Sopehurt/kiosk_pcb/PCB_CAT_Vending_Machine_V1.0.kicad_pcb

## KiCad design PCB_CAT_Vending_Machine_V1.0.kicad_pcb (2026-05-17)

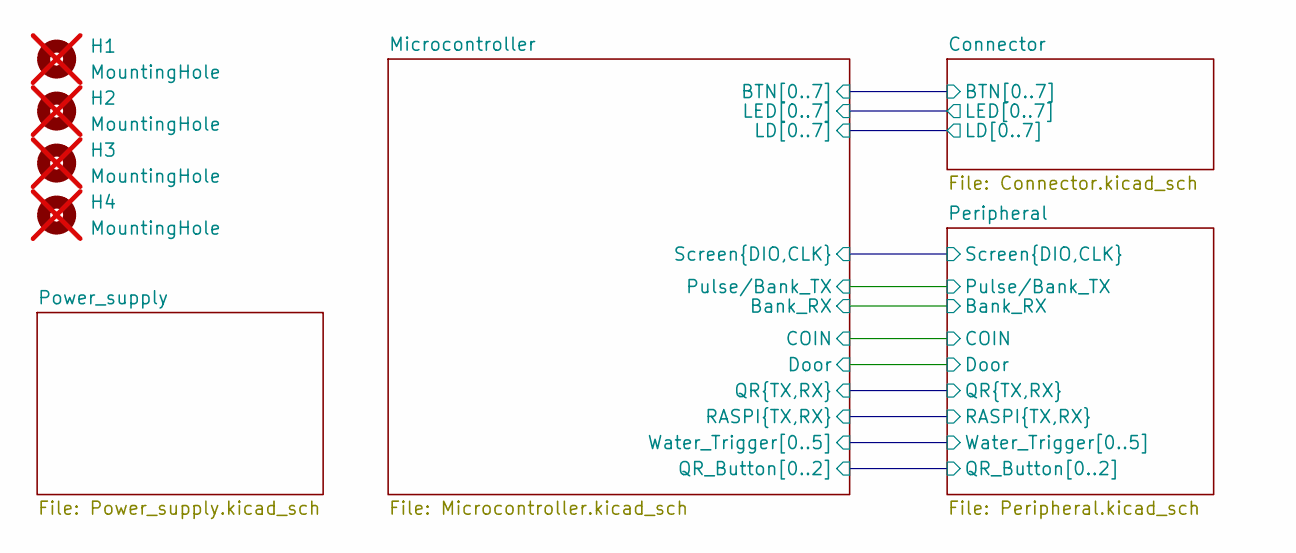
[picture p1: schematic PCB_CAT_Vending_Machine_V1.0.kicad_sch]

Parts:
H1, H2, H3, H4: MountingHole; MountingHole_3.2mm_M3_Pad_TopBottom; not fitted

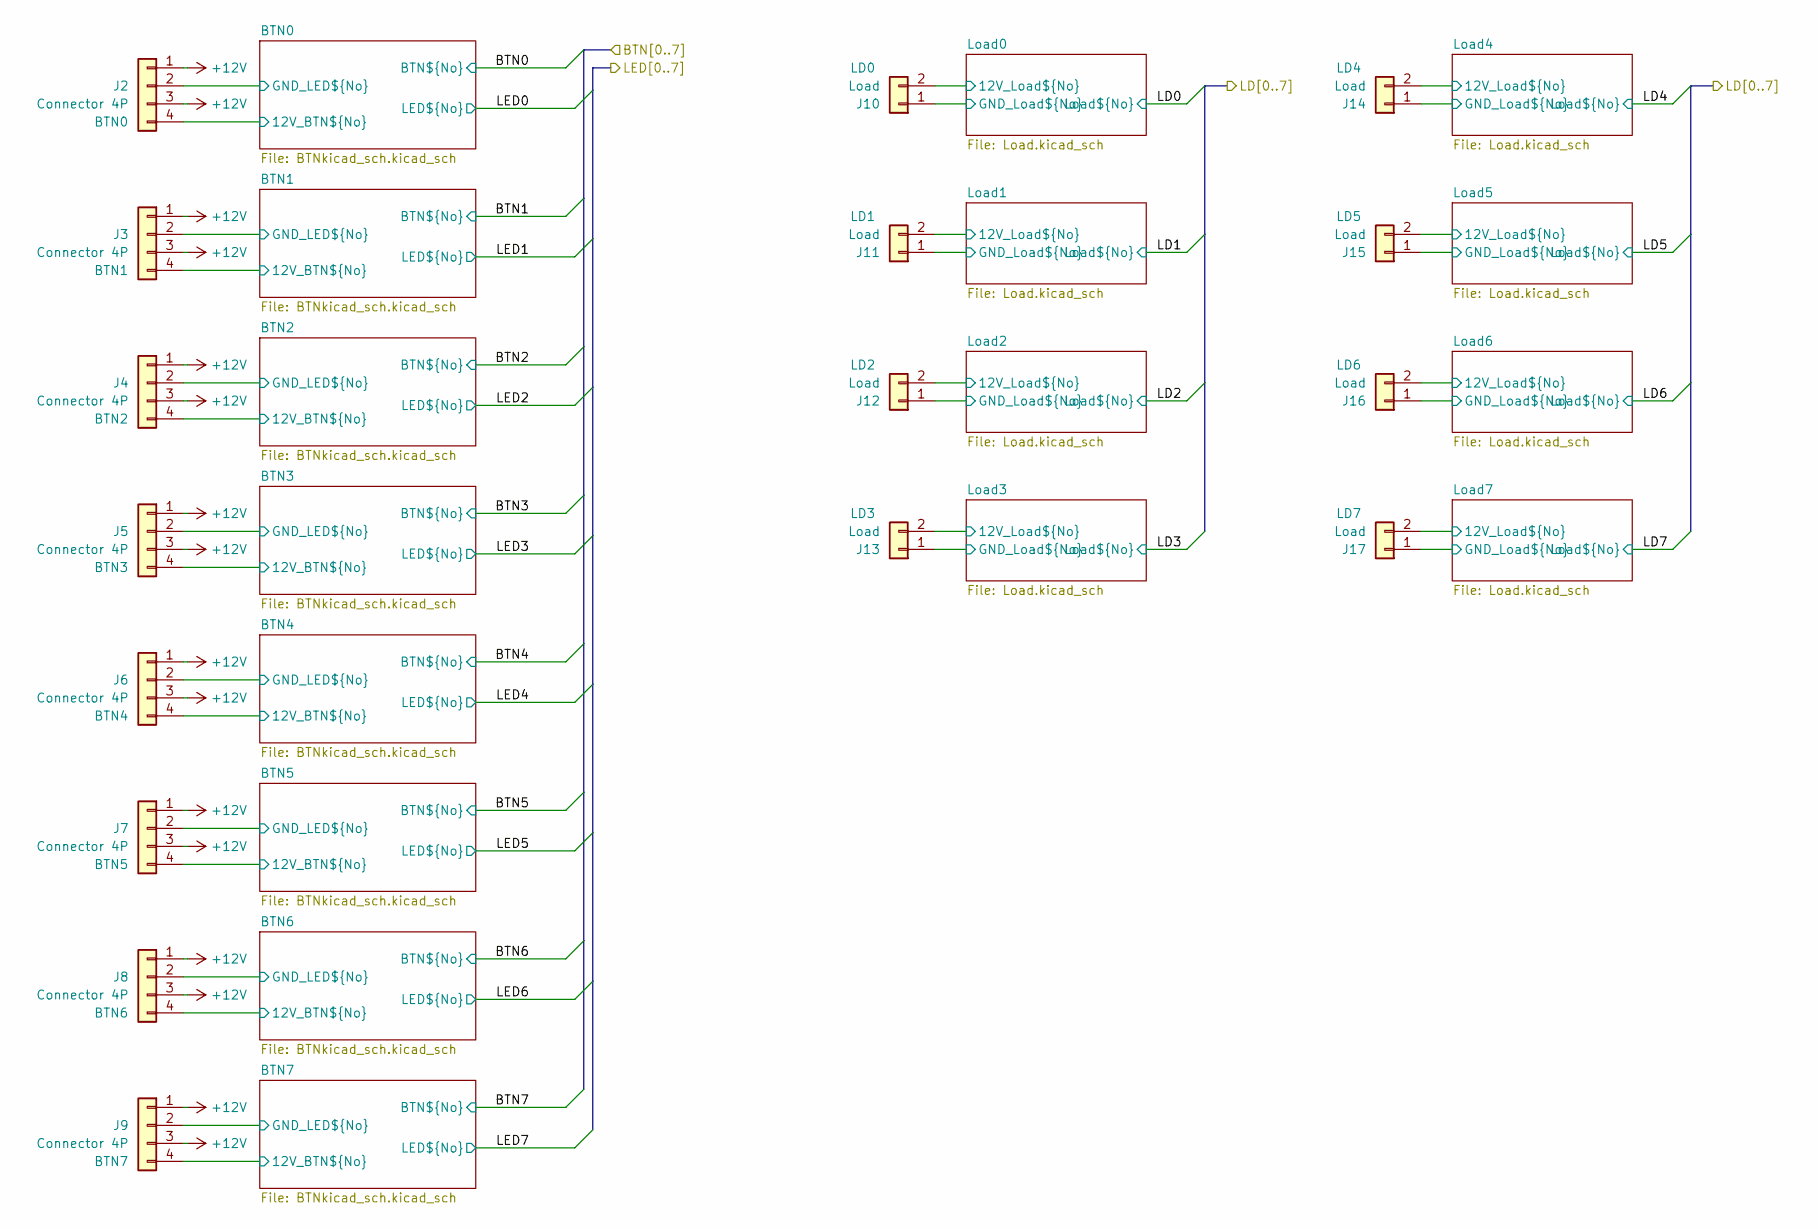
[picture p2: schematic Connector.kicad_sch]

Parts:
J2, J3, J4, J5, J6, J7, J8, J9: Connector 4P; JST_XH_B4B-XH-A_1x04_P2.50mm_Vertical; LCSC C7429634
J10, J11, J12, J13, J14, J15, J16, J17: Load; CONN-TH_CH5.08-2A; LCSC C27692

Connections:
+12V: J2.1, J2.3, J3.1, J3.3, J4.1, J4.3, J5.1, J5.3, J6.1, J6.3, J7.1, J7.3, J8.1, J8.3, J9.1, J9.3, J10.2, J11.2, J12.2, J13.2, J14.2, J15.2, J16.2, J17.2; also elsewhere on the board
/Connector/BTN0/12V_BTN0: J2.4; also elsewhere on the board
/Connector/BTN0/GND_LED0: J2.2; also elsewhere on the board
/Connector/BTN1/12V_BTN1: J3.4; also elsewhere on the board
/Connector/BTN1/GND_LED1: J3.2; also elsewhere on the board
/Connector/BTN2/12V_BTN2: J4.4; also elsewhere on the board
/Connector/BTN2/GND_LED2: J4.2; also elsewhere on the board
/Connector/BTN3/12V_BTN3: J5.4; also elsewhere on the board
/Connector/BTN3/GND_LED3: J5.2; also elsewhere on the board
/Connector/BTN4/12V_BTN4: J6.4; also elsewhere on the board
/Connector/BTN4/GND_LED4: J6.2; also elsewhere on the board
/Connector/BTN5/12V_BTN5: J7.4; also elsewhere on the board
/Connector/BTN5/GND_LED5: J7.2; also elsewhere on the board
/Connector/BTN6/12V_BTN6: J8.4; also elsewhere on the board
/Connector/BTN6/GND_LED6: J8.2; also elsewhere on the board
/Connector/BTN7/12V_BTN7: J9.4; also elsewhere on the board
/Connector/BTN7/GND_LED7: J9.2; also elsewhere on the board
/Connector/Load0/GND_Load0: J10.1; also elsewhere on the board
/Connector/Load1/GND_Load1: J11.1; also elsewhere on the board
/Connector/Load2/GND_Load2: J12.1; also elsewhere on the board
/Connector/Load3/GND_Load3: J13.1; also elsewhere on the board
/Connector/Load4/GND_Load4: J14.1; also elsewhere on the board
/Connector/Load5/GND_Load5: J15.1; also elsewhere on the board
/Connector/Load6/GND_Load6: J16.1; also elsewhere on the board
/Connector/Load7/GND_Load7: J17.1; also elsewhere on the board

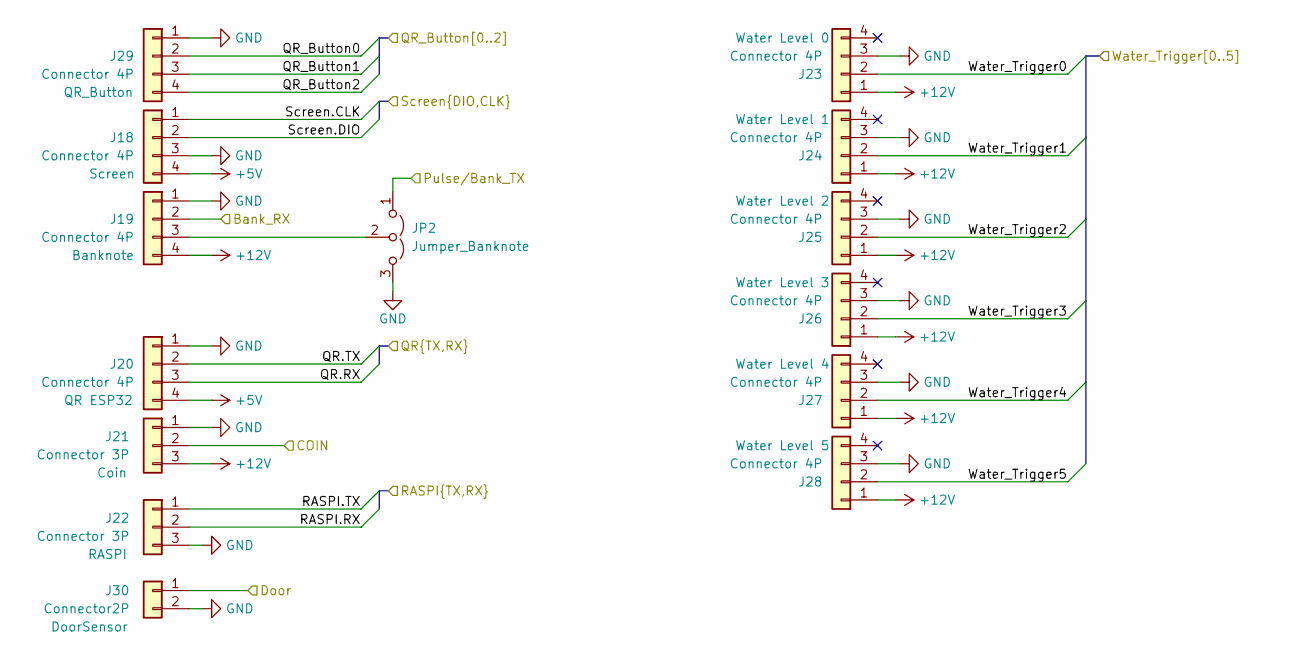
[picture p3: schematic Peripheral.kicad_sch]

Parts:
J18, J19, J20, J23, J24, J25, J26, J27, J28, J29: Connector 4P; JST_XH_B4B-XH-A_1x04_P2.50mm_Vertical; LCSC C7429634
J21, J22: Connector 3P; JST_XH_B3B-XH-A_1x03_P2.50mm_Vertical; LCSC C7429633
J30: Connector2P; JST_XH_B2B-XH-A_1x02_P2.50mm_Vertical; LCSC C42441529
JP2: Jumper_Banknote; PinHeader_1x03_P2.54mm_Vertical; LCSC C52016391

Connections:
+5V: J18.4, J20.4; also elsewhere on the board
+12V: J19.4, J21.3, J23.1, J24.1, J25.1, J26.1, J27.1, J28.1; also elsewhere on the board
/Microcontroller/Bank_RX: J19.2; also elsewhere on the board
/Microcontroller/COIN: J21.2; also elsewhere on the board
/Microcontroller/Door: J30.1; also elsewhere on the board
/Microcontroller/Pulse/Bank_TX: JP2.1 (A); also elsewhere on the board
/Microcontroller/QR.RX: J20.3; also elsewhere on the board
/Microcontroller/QR.TX: J20.2; also elsewhere on the board
/Microcontroller/QR_Button0: J29.2; also elsewhere on the board
/Microcontroller/QR_Button1: J29.3; also elsewhere on the board
/Microcontroller/QR_Button2: J29.4; also elsewhere on the board
/Microcontroller/RASPI.RX: J22.2; also elsewhere on the board
/Microcontroller/RASPI.TX: J22.1; also elsewhere on the board
/Microcontroller/Screen.CLK: J18.1; also elsewhere on the board
/Microcontroller/Screen.DIO: J18.2; also elsewhere on the board
/Microcontroller/Water_Trigger0: J23.2; also elsewhere on the board
/Microcontroller/Water_Trigger1: J24.2; also elsewhere on the board
/Microcontroller/Water_Trigger2: J25.2; also elsewhere on the board
/Microcontroller/Water_Trigger3: J26.2; also elsewhere on the board
/Microcontroller/Water_Trigger4: J27.2; also elsewhere on the board
/Microcontroller/Water_Trigger5: J28.2; also elsewhere on the board
GND: J18.3, J19.1, J20.1, J21.1, J22.3, J23.3, J24.3, J25.3, J26.3, J27.3, J28.3, J29.1, J30.2, JP2.3 (B); also elsewhere on the board
unnamed: J19.3, JP2.2 (C)

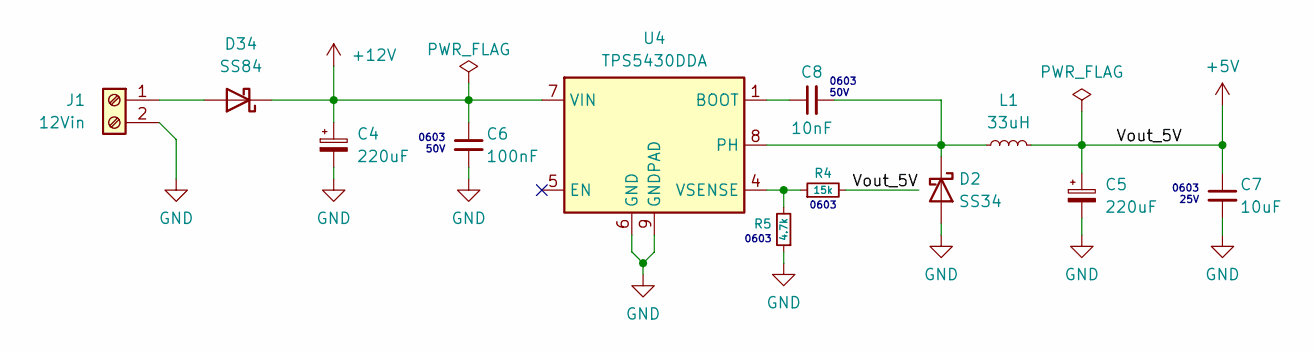
[picture p4: schematic Power_supply.kicad_sch]

Parts:
C4, C5: 220uF; CP_Elec_6.3x7.7; LCSC C696188
C6: 100nF; C_0603_1608Metric; LCSC C14663
C7: 10uF; C_0603_1608Metric; LCSC C96446
C8: 10nF; C_0603_1608Metric; LCSC C57112
D2: SS34; D_SMA; LCSC C8678
D34: SS84; D_SMC; JLC C2943761
J1: 12Vin; CONN-TH_2P-P5.00_XY2500V-D-5.00-2P; LCSC C505779
L1: 33uH; L_TechFuse_SL0650; LCSC C5127476
R4: 15k; R_0603_1608Metric; LCSC C22809
R5: 4.7k; R_0603_1608Metric; LCSC C23162
U4: TPS5430DDA; TI_SO-PowerPAD-8_ThermalVias; LCSC C9864

Connections:
+5V: C5.1, C7.1, L1.2, R4.2; also elsewhere on the board
+12V: C4.1, C6.1, D34.1 (K), U4.7 (VIN); also elsewhere on the board
GND: C4.2, C5.2, C6.2, C7.2, D2.2 (A), J1.2, R5.1, U4.6 (GND), U4.9 (GNDPAD); also elsewhere on the board
unnamed: C8.2, D2.1 (K), L1.1, U4.8 (PH)
unnamed: D34.2 (A), J1.1
unnamed: C8.1, U4.1 (BOOT)
unnamed: R4.1, R5.2, U4.4 (VSENSE)

Notes on the sheet:
0603 50V
0603 25V
0603

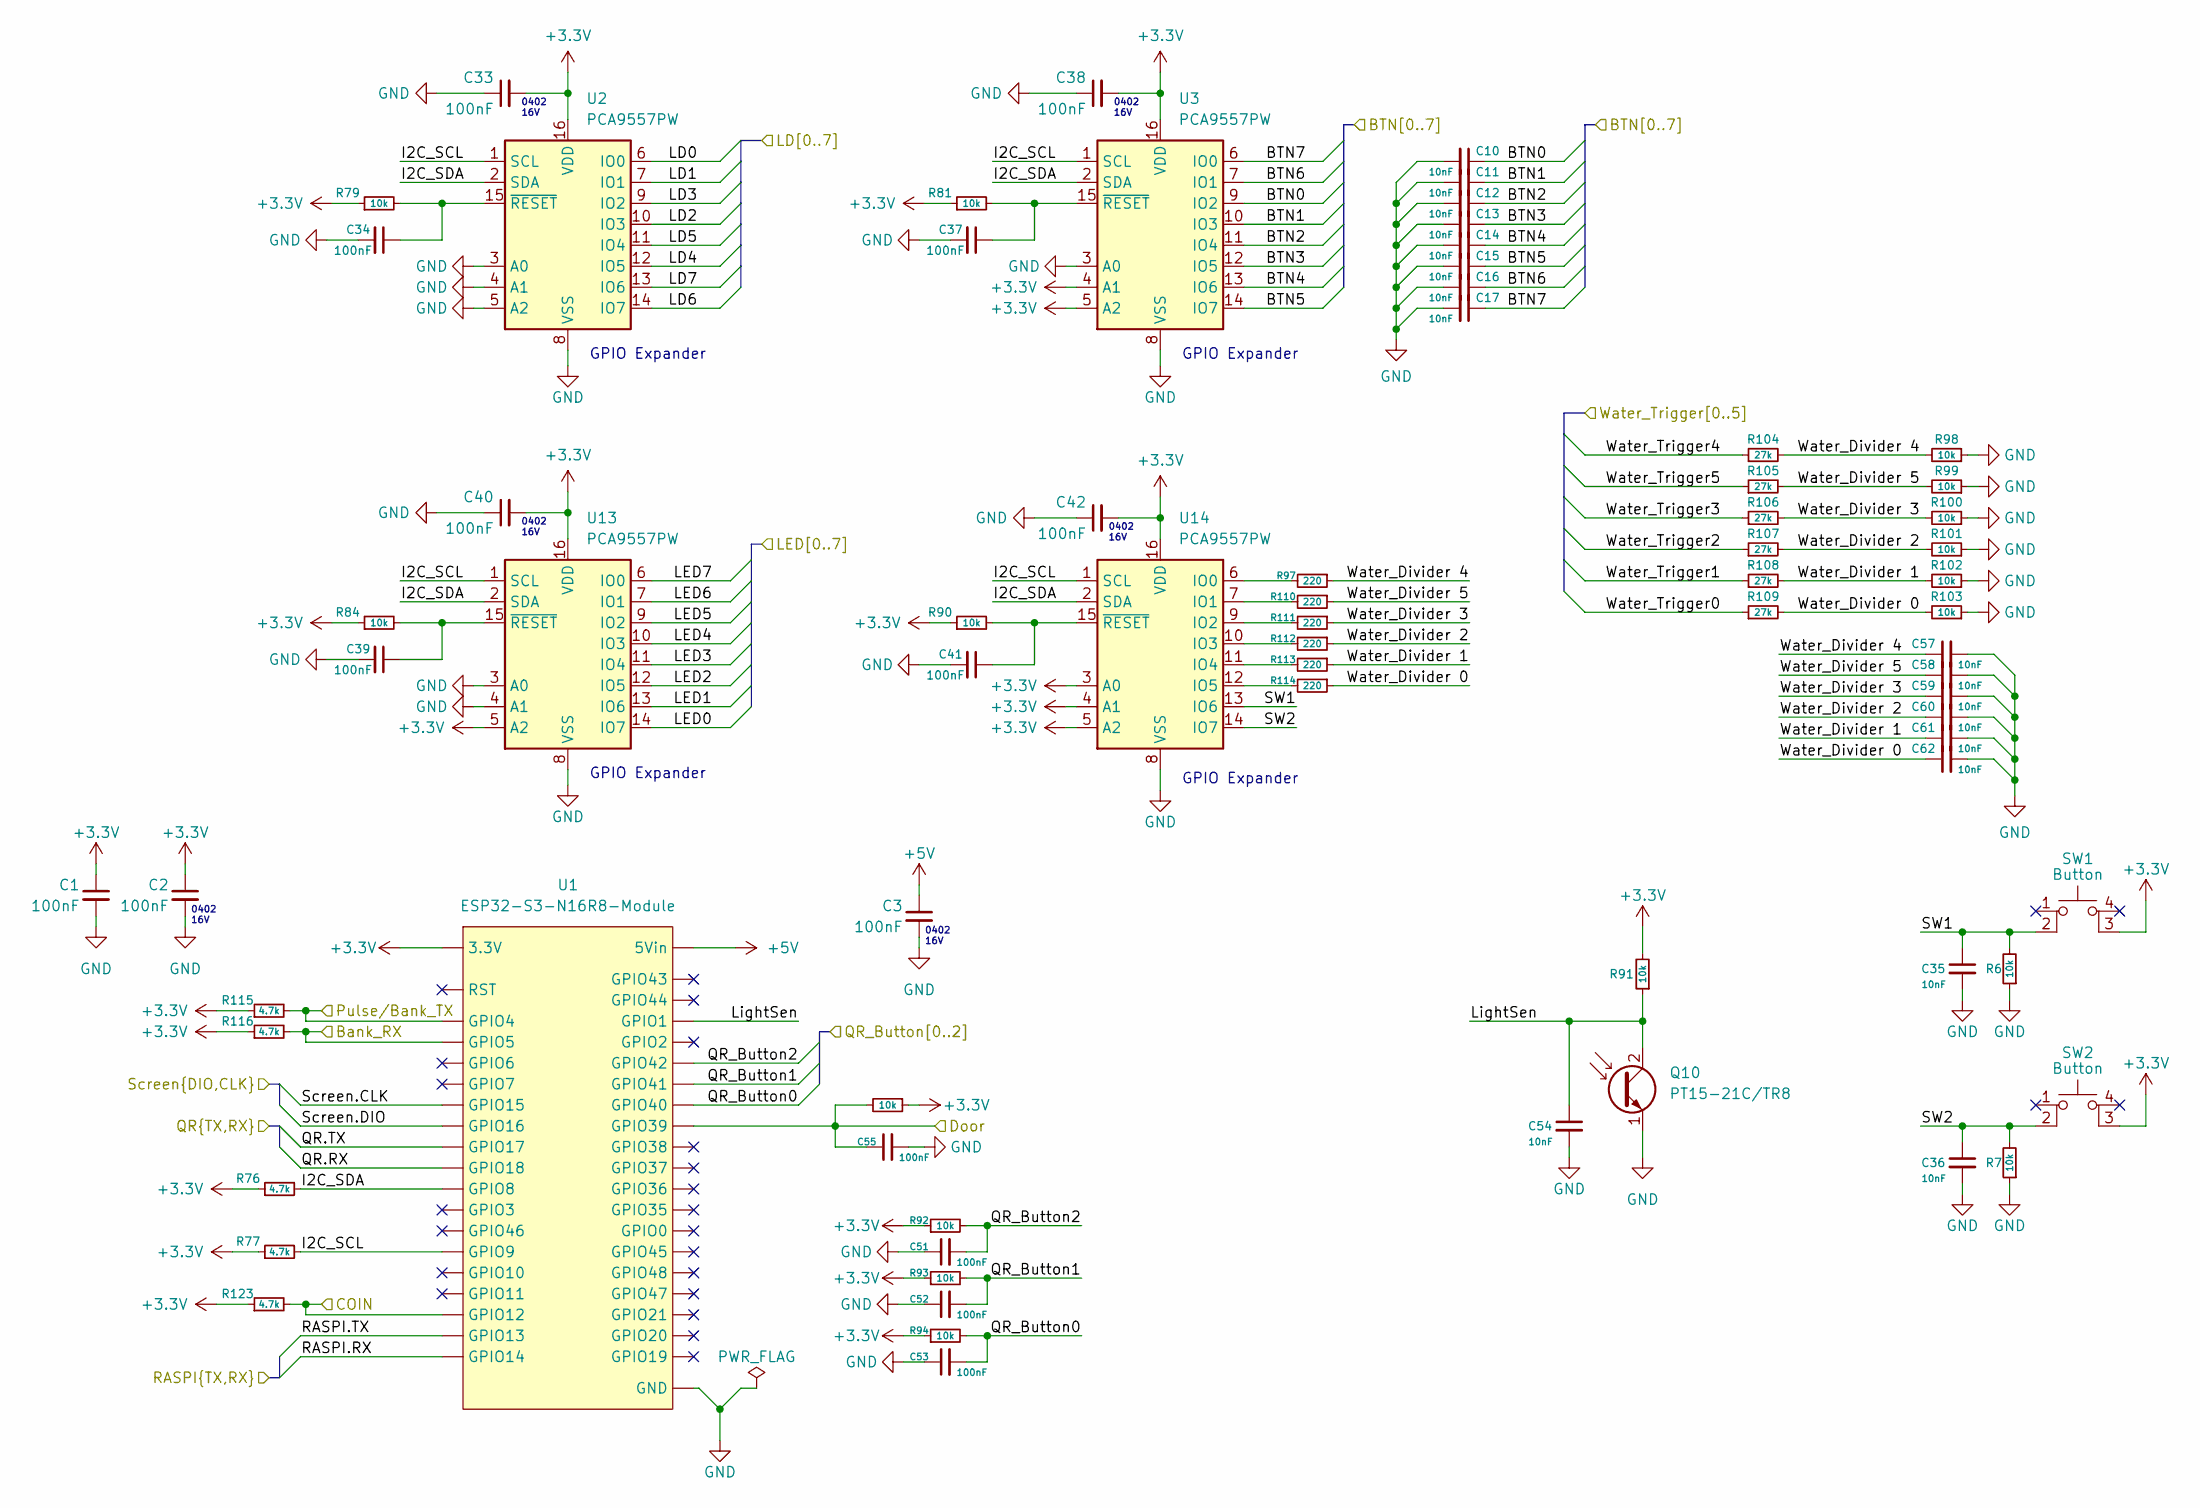
[picture p5: schematic Microcontroller.kicad_sch]

Parts:
C1, C2, C3, C33, C34, C37, C38, C39, C40, C41, C42, C51, C52, C53, C55: 100nF; C_0402_1005Metric; LCSC C1525
C10, C11, C12, C13, C14, C15, C16, C17, C35, C36, C54, C57, C58, C59, C60, C61, C62: 10nF; C_0402_1005Metric; LCSC C15195
Q10: PT15-21C/TR8; LED_1206_3216Metric; LCSC C41383389
R6, R7, R79, R81, R84, R90, R91, R92, R93, R94, R95, R98, R99, R100, R101, R102, R103: 10k; R_0402_1005Metric; LCSC C25744
R76, R77, R115, R116, R123: 4.7k; R_0402_1005Metric; LCSC C25900
R97, R110, R111, R112, R113, R114: 220; R_0402_1005Metric; LCSC C25091
R104, R105, R106, R107, R108, R109: 27k; R_0603_1608Metric; LCSC C22967
SW1, SW2: Button; 430182043816; LCSC C5340127
U1: ESP32-S3-N16R8-Module; ESP32-S3 N16R8-Module
U2, U3, U13, U14: PCA9557PW; TSSOP-16_4.4x5mm_P0.65mm; LCSC C141380

Connections:
+3.3V: C1.1, C2.1, C33.2, C38.2, C40.2, C42.2, R76.1, R77.1, R79.1, R81.1, R84.1, R90.1, R91.2, R92.1, R93.1, R94.1, R95.1, R115.1, R116.1, R123.1, SW1.3 (K), SW2.3 (K), U1.1 (3.3V), U1.2 (3.3V), U2.16 (VDD), U3.4 (A1), U3.5 (A2), U3.16 (VDD), U13.5 (A2), U13.16 (VDD), U14.3 (A0), U14.4 (A1), U14.5 (A2), U14.16 (VDD); also elsewhere on the board
+5V: C3.1, U1.21 (5Vin); also elsewhere on the board
/Connector/BTN0: C10.1, U3.9 (IO2); also elsewhere on the board
/Connector/BTN1: C11.1, U3.10 (IO3); also elsewhere on the board
/Connector/BTN2: C12.1, U3.11 (IO4); also elsewhere on the board
/Connector/BTN3: C13.1, U3.12 (IO5); also elsewhere on the board
/Connector/BTN4: C14.1, U3.13 (IO6); also elsewhere on the board
/Connector/BTN5: C15.1, U3.14 (IO7); also elsewhere on the board
/Connector/BTN6: C16.1, U3.7 (IO1); also elsewhere on the board
/Connector/BTN7: C17.1, U3.6 (IO0); also elsewhere on the board
/Connector/LD0: U2.6 (IO0); also elsewhere on the board
/Connector/LD1: U2.7 (IO1); also elsewhere on the board
/Connector/LD2: U2.10 (IO3); also elsewhere on the board
/Connector/LD3: U2.9 (IO2); also elsewhere on the board
/Connector/LD4: U2.12 (IO5); also elsewhere on the board
/Connector/LD5: U2.11 (IO4); also elsewhere on the board
/Connector/LD6: U2.14 (IO7); also elsewhere on the board
/Connector/LD7: U2.13 (IO6); also elsewhere on the board
/Connector/LED0: U13.14 (IO7); also elsewhere on the board
/Connector/LED1: U13.13 (IO6); also elsewhere on the board
/Connector/LED2: U13.12 (IO5); also elsewhere on the board
/Connector/LED3: U13.11 (IO4); also elsewhere on the board
/Connector/LED4: U13.10 (IO3); also elsewhere on the board
/Connector/LED5: U13.9 (IO2); also elsewhere on the board
/Connector/LED6: U13.7 (IO1); also elsewhere on the board
/Connector/LED7: U13.6 (IO0); also elsewhere on the board
/Microcontroller/Bank_RX: R116.2, U1.5 (GPIO5); also elsewhere on the board
/Microcontroller/COIN: R123.2, U1.18 (GPIO12); also elsewhere on the board
/Microcontroller/Door: C55.1, R95.2, U1.36 (GPIO39); also elsewhere on the board
/Microcontroller/I2C_SCL: R77.2, U1.15 (GPIO9), U2.1 (SCL), U3.1 (SCL), U13.1 (SCL), U14.1 (SCL)
/Microcontroller/I2C_SDA: R76.2, U1.12 (GPIO8), U2.2 (SDA), U3.2 (SDA), U13.2 (SDA), U14.2 (SDA)
/Microcontroller/LightSen: C54.1, Q10.2 (C), R91.1, U1.41 (GPIO1)
/Microcontroller/Pulse/Bank_TX: R115.2, U1.4 (GPIO4); also elsewhere on the board
/Microcontroller/QR.RX: U1.11 (GPIO18); also elsewhere on the board
/Microcontroller/QR.TX: U1.10 (GPIO17); also elsewhere on the board
/Microcontroller/QR_Button0: C53.2, R94.2, U1.37 (GPIO40); also elsewhere on the board
/Microcontroller/QR_Button1: C52.2, R93.2, U1.38 (GPIO41); also elsewhere on the board
/Microcontroller/QR_Button2: C51.2, R92.2, U1.39 (GPIO42); also elsewhere on the board
/Microcontroller/RASPI.RX: U1.20 (GPIO14); also elsewhere on the board
/Microcontroller/RASPI.TX: U1.19 (GPIO13); also elsewhere on the board
/Microcontroller/SW1: C35.1, R6.2, SW1.2, U14.13 (IO6)
/Microcontroller/SW2: C36.1, R7.2, SW2.2, U14.14 (IO7)
/Microcontroller/Screen.CLK: U1.8 (GPIO15); also elsewhere on the board
/Microcontroller/Screen.DIO: U1.9 (GPIO16); also elsewhere on the board
/Microcontroller/Water_Divider 0: C62.1, R103.2, R109.2, R114.1
/Microcontroller/Water_Divider 1: C61.1, R102.2, R108.2, R113.1
/Microcontroller/Water_Divider 2: C60.1, R101.2, R107.2, R112.1
/Microcontroller/Water_Divider 3: C59.1, R100.2, R106.2, R111.1
/Microcontroller/Water_Divider 4: C57.1, R97.1, R98.2, R104.2
/Microcontroller/Water_Divider 5: C58.1, R99.2, R105.2, R110.1
/Microcontroller/Water_Trigger0: R109.1; also elsewhere on the board
/Microcontroller/Water_Trigger1: R108.1; also elsewhere on the board
/Microcontroller/Water_Trigger2: R107.1; also elsewhere on the board
/Microcontroller/Water_Trigger3: R106.1; also elsewhere on the board
/Microcontroller/Water_Trigger4: R104.1; also elsewhere on the board
/Microcontroller/Water_Trigger5: R105.1; also elsewhere on the board
GND: C1.2, C2.2, C3.2, C10.2, C11.2, C12.2, C13.2, C14.2, C15.2, C16.2, C17.2, C33.1, C34.2, C35.2, C36.2, C37.2, C38.1, C39.2, C40.1, C41.2, C42.1, C51.1, C52.1, C53.1, C54.2, C55.2, C57.2, C58.2, C59.2, C60.2, C61.2, C62.2, Q10.1 (E), R6.1, R7.1, R98.1, R99.1, R100.1, R101.1, R102.1, R103.1, U1.22 (GND), U1.23 (GND), U1.24 (GND), U1.44 (GND), U2.3 (A0), U2.4 (A1), U2.5 (A2), U2.8 (VSS), U3.3 (A0), U3.8 (VSS), U13.3 (A0), U13.4 (A1), U13.8 (VSS), U14.8 (VSS); also elsewhere on the board
unnamed: C34.1, R79.2, U2.15 (~RESET)
unnamed: C37.1, R81.2, U3.15 (~RESET)
unnamed: C39.1, R84.2, U13.15 (~RESET)
unnamed: R97.2, U14.6 (IO0)
unnamed: R110.2, U14.7 (IO1)
unnamed: R111.2, U14.9 (IO2)
unnamed: R112.2, U14.10 (IO3)
unnamed: R113.2, U14.11 (IO4)
unnamed: R114.2, U14.12 (IO5)
unnamed: C41.1, R90.2, U14.15 (~RESET)

Notes on the sheet:
GPIO Expander
0402 16V

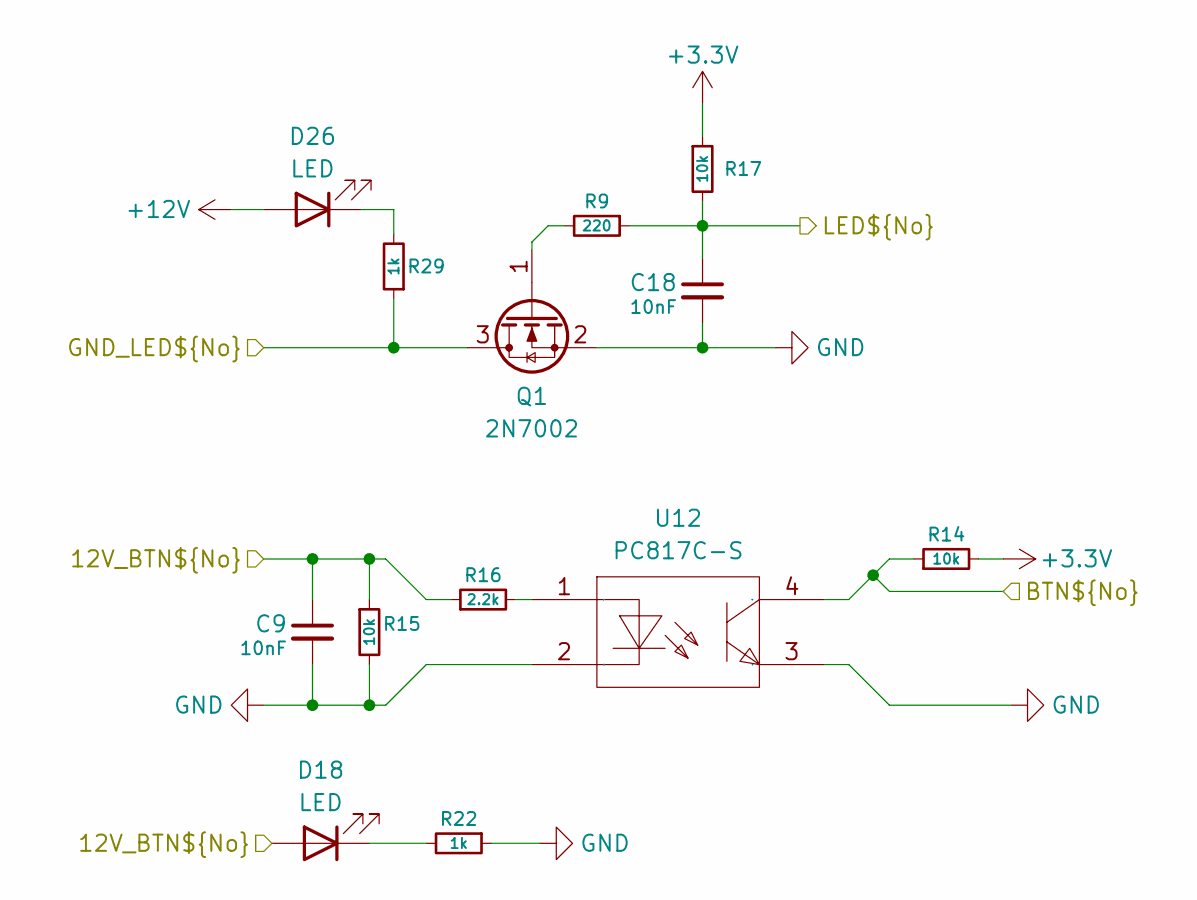
[picture p6: schematic BTNkicad_sch.kicad_sch]

Parts:
C9, C18: 10nF; C_0402_1005Metric; LCSC C15195
D18, D26: LED; LED_0603_1608Metric; LCSC C2290
Q1: 2N7002; SOT-23; LCSC C8545
R9: 220; R_0402_1005Metric; LCSC C25091
R14, R15, R17: 10k; R_0402_1005Metric; LCSC C25744
R16: 2.2k; R_0402_1005Metric; LCSC C25879
R22, R29: 1k; R_0402_1005Metric; LCSC C4109
U12: PC817C-S; SOP-4_L6.5-W4.6-P2.54-LS10.3-TL; Manufacturer Part PC817C-S; LCSC Part Name 光耦合器

Connections:
+3.3V: R14.2, R17.1; also elsewhere on the board
+12V: D26.2 (A); also elsewhere on the board
/Connector/BTN0: R14.1, U12.4 (COL); also elsewhere on the board
/Connector/BTN0/12V_BTN0: C9.1, D18.2 (A), R15.1, R16.1; also elsewhere on the board
/Connector/BTN0/GND_LED0: Q1.3 (D), R29.1; also elsewhere on the board
/Connector/LED0: C18.1, R9.1, R17.2; also elsewhere on the board
GND: C9.2, C18.2, Q1.2 (S), R15.2, R22.1, U12.2 (CAT), U12.3 (EM); also elsewhere on the board
unnamed: D18.1 (K), R22.2
unnamed: D26.1 (K), R29.2
unnamed: Q1.1 (G), R9.2
unnamed: R16.2, U12.1 (AN)

Parts of its further copies:
C19, C20, C21, C22, C23, C24, C25, C26, C27, C28, C29, C30, C31, C32: 10nF; C_0402_1005Metric; LCSC C15195
D19, D20, D21, D22, D23, D24, D25, D27, D28, D29, D30, D31, D32, D33: LED; LED_0603_1608Metric; LCSC C2290
Q2, Q4, Q5, Q6, Q7, Q8, Q9: 2N7002; SOT-23; LCSC C8545
R18, R21, R23, R24, R27, R45, R46, R49, R51, R52, R55, R57, R58, R61, R63, R64, R67, R69, R70, R73, R75: 10k; R_0402_1005Metric; LCSC C25744
R19, R25, R47, R53, R59, R65, R71: 2.2k; R_0402_1005Metric; LCSC C25879
R20, R26, R48, R54, R60, R66, R72: 220; R_0402_1005Metric; LCSC C25091
R31, R33, R35, R37, R39, R41, R43, R44, R50, R56, R62, R68, R74, R78: 1k; R_0402_1005Metric; LCSC C4109
U5, U6, U7, U8, U9, U10, U11: PC817C-S; SOP-4_L6.5-W4.6-P2.54-LS10.3-TL; Manufacturer Part PC817C-S; LCSC Part Name 光耦合器

Connections of its further copies:
+3.3V: R21.1, R23.2, R27.1, R45.2, R49.1, R51.2, R55.1, R57.2, R61.1, R63.2, R67.1, R69.2, R73.1, R75.2; also elsewhere on the board
+12V: D27.2 (A), D28.2 (A), D29.2 (A), D30.2 (A), D31.2 (A), D32.2 (A), D33.2 (A); also elsewhere on the board
/Connector/BTN1: R23.1, U5.4 (COL); also elsewhere on the board
/Connector/BTN1/12V_BTN1: C19.1, D19.2 (A), R18.1, R19.1; also elsewhere on the board
/Connector/BTN1/GND_LED1: Q2.3 (D), R31.1; also elsewhere on the board
/Connector/BTN2: R45.1, U6.4 (COL); also elsewhere on the board
/Connector/BTN2/12V_BTN2: C21.1, D20.2 (A), R24.1, R25.1; also elsewhere on the board
/Connector/BTN2/GND_LED2: Q4.3 (D), R33.1; also elsewhere on the board
/Connector/BTN3: R51.1, U7.4 (COL); also elsewhere on the board
/Connector/BTN3/12V_BTN3: C23.1, D21.2 (A), R46.1, R47.1; also elsewhere on the board
/Connector/BTN3/GND_LED3: Q5.3 (D), R35.1; also elsewhere on the board
/Connector/BTN4: R57.1, U8.4 (COL); also elsewhere on the board
/Connector/BTN4/12V_BTN4: C25.1, D22.2 (A), R52.1, R53.1; also elsewhere on the board
/Connector/BTN4/GND_LED4: Q6.3 (D), R37.1; also elsewhere on the board
/Connector/BTN5: R63.1, U9.4 (COL); also elsewhere on the board
/Connector/BTN5/12V_BTN5: C27.1, D23.2 (A), R58.1, R59.1; also elsewhere on the board
/Connector/BTN5/GND_LED5: Q7.3 (D), R39.1; also elsewhere on the board
/Connector/BTN6: R69.1, U10.4 (COL); also elsewhere on the board
/Connector/BTN6/12V_BTN6: C29.1, D24.2 (A), R64.1, R65.1; also elsewhere on the board
/Connector/BTN6/GND_LED6: Q8.3 (D), R41.1; also elsewhere on the board
/Connector/BTN7: R75.1, U11.4 (COL); also elsewhere on the board
/Connector/BTN7/12V_BTN7: C31.1, D25.2 (A), R70.1, R71.1; also elsewhere on the board
/Connector/BTN7/GND_LED7: Q9.3 (D), R43.1; also elsewhere on the board
/Connector/LED1: C20.1, R20.1, R21.2; also elsewhere on the board
/Connector/LED2: C22.1, R26.1, R27.2; also elsewhere on the board
/Connector/LED3: C24.1, R48.1, R49.2; also elsewhere on the board
/Connector/LED4: C26.1, R54.1, R55.2; also elsewhere on the board
/Connector/LED5: C28.1, R60.1, R61.2; also elsewhere on the board
/Connector/LED6: C30.1, R66.1, R67.2; also elsewhere on the board
/Connector/LED7: C32.1, R72.1, R73.2; also elsewhere on the board
GND: C19.2, C20.2, C21.2, C22.2, C23.2, C24.2, C25.2, C26.2, C27.2, C28.2, C29.2, C30.2, C31.2, C32.2, Q2.2 (S), Q4.2 (S), Q5.2 (S), Q6.2 (S), Q7.2 (S), Q8.2 (S), Q9.2 (S), R18.2, R24.2, R44.1, R46.2, R50.1, R52.2, R56.1, R58.2, R62.1, R64.2, R68.1, R70.2, R74.1, R78.1, U5.2 (CAT), U5.3 (EM), U6.2 (CAT), U6.3 (EM), U7.2 (CAT), U7.3 (EM), U8.2 (CAT), U8.3 (EM), U9.2 (CAT), U9.3 (EM), U10.2 (CAT), U10.3 (EM), U11.2 (CAT), U11.3 (EM); also elsewhere on the board
unnamed: D19.1 (K), R44.2
unnamed: D20.1 (K), R50.2
unnamed: D21.1 (K), R56.2
unnamed: D22.1 (K), R62.2
unnamed: D23.1 (K), R68.2
unnamed: D24.1 (K), R74.2
unnamed: D25.1 (K), R78.2
unnamed: D27.1 (K), R31.2
unnamed: D28.1 (K), R33.2
unnamed: D29.1 (K), R35.2
unnamed: D30.1 (K), R37.2
unnamed: D31.1 (K), R39.2
unnamed: D32.1 (K), R41.2
unnamed: D33.1 (K), R43.2
unnamed: Q2.1 (G), R20.2
unnamed: Q4.1 (G), R26.2
unnamed: Q5.1 (G), R48.2
unnamed: Q6.1 (G), R54.2
unnamed: Q7.1 (G), R60.2
unnamed: Q8.1 (G), R66.2
unnamed: Q9.1 (G), R72.2
unnamed: R19.2, U5.1 (AN)
unnamed: R25.2, U6.1 (AN)
unnamed: R47.2, U7.1 (AN)
unnamed: R53.2, U8.1 (AN)
unnamed: R59.2, U9.1 (AN)
unnamed: R65.2, U10.1 (AN)
unnamed: R71.2, U11.1 (AN)

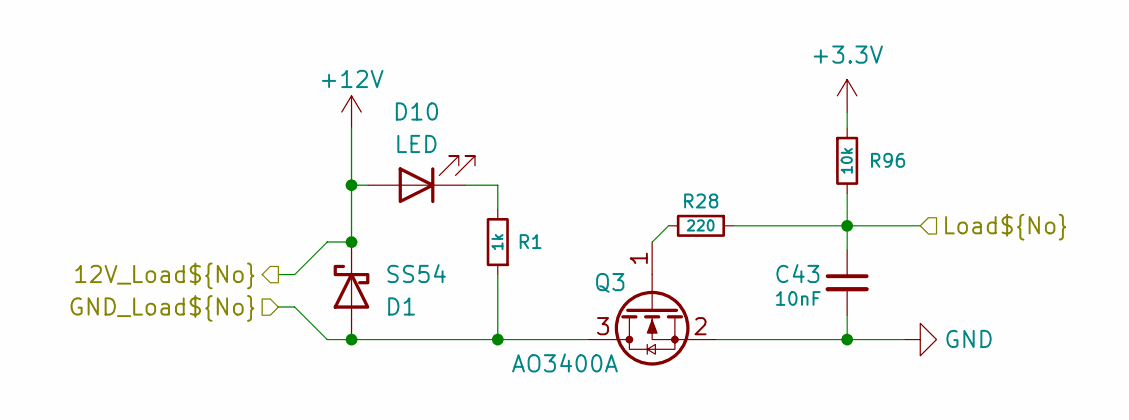
[picture p7: schematic Load.kicad_sch]

Parts:
C43: 10nF; C_0402_1005Metric; LCSC C15195
D1: SS54; D_SMA; LCSC C22452
D10: LED; LED_0603_1608Metric; LCSC C2290
Q3: AO3400A; SOT-23; LCSC C20917
R1: 1k; R_0402_1005Metric; LCSC C4109
R28: 220; R_0402_1005Metric; LCSC C25091
R96: 10k; R_0402_1005Metric; LCSC C25744

Connections:
+3.3V: R96.1; also elsewhere on the board
+12V: D1.1 (K), D10.2 (A); also elsewhere on the board
/Connector/LD0: C43.1, R28.1, R96.2; also elsewhere on the board
/Connector/Load0/GND_Load0: D1.2 (A), Q3.3 (D), R1.1; also elsewhere on the board
GND: C43.2, Q3.2 (S); also elsewhere on the board
unnamed: D10.1 (K), R1.2
unnamed: Q3.1 (G), R28.2

Parts of its further copies:
C44, C45, C46, C47, C48, C49, C50: 10nF; C_0402_1005Metric; LCSC C15195
D3, D4, D5, D6, D7, D8, D9: SS54; D_SMA; LCSC C22452
D11, D12, D13, D14, D15, D16, D17: LED; LED_0603_1608Metric; LCSC C2290
Q12, Q13, Q14, Q15, Q16, Q17, Q18: AO3400A; SOT-23; LCSC C20917
R2, R3, R8, R10, R11, R12, R13: 1k; R_0402_1005Metric; LCSC C4109
R30, R32, R34, R36, R38, R40, R42: 220; R_0402_1005Metric; LCSC C25091
R117, R118, R119, R120, R121, R122, R124: 10k; R_0402_1005Metric; LCSC C25744

Connections of its further copies:
+3.3V: R117.1, R118.1, R119.1, R120.1, R121.1, R122.1, R124.1; also elsewhere on the board
+12V: D3.1 (K), D4.1 (K), D5.1 (K), D6.1 (K), D7.1 (K), D8.1 (K), D9.1 (K), D11.2 (A), D12.2 (A), D13.2 (A), D14.2 (A), D15.2 (A), D16.2 (A), D17.2 (A); also elsewhere on the board
/Connector/LD1: C44.1, R30.1, R117.2; also elsewhere on the board
/Connector/LD2: C45.1, R32.1, R118.2; also elsewhere on the board
/Connector/LD3: C46.1, R34.1, R119.2; also elsewhere on the board
/Connector/LD4: C47.1, R36.1, R120.2; also elsewhere on the board
/Connector/LD5: C48.1, R38.1, R121.2; also elsewhere on the board
/Connector/LD6: C49.1, R40.1, R122.2; also elsewhere on the board
/Connector/LD7: C50.1, R42.1, R124.2; also elsewhere on the board
/Connector/Load1/GND_Load1: D3.2 (A), Q12.3 (D), R2.1; also elsewhere on the board
/Connector/Load2/GND_Load2: D4.2 (A), Q13.3 (D), R3.1; also elsewhere on the board
/Connector/Load3/GND_Load3: D5.2 (A), Q14.3 (D), R8.1; also elsewhere on the board
/Connector/Load4/GND_Load4: D6.2 (A), Q15.3 (D), R10.1; also elsewhere on the board
/Connector/Load5/GND_Load5: D7.2 (A), Q16.3 (D), R11.1; also elsewhere on the board
/Connector/Load6/GND_Load6: D8.2 (A), Q17.3 (D), R12.1; also elsewhere on the board
/Connector/Load7/GND_Load7: D9.2 (A), Q18.3 (D), R13.1; also elsewhere on the board
GND: C44.2, C45.2, C46.2, C47.2, C48.2, C49.2, C50.2, Q12.2 (S), Q13.2 (S), Q14.2 (S), Q15.2 (S), Q16.2 (S), Q17.2 (S), Q18.2 (S); also elsewhere on the board
unnamed: D11.1 (K), R2.2
unnamed: D12.1 (K), R3.2
unnamed: D13.1 (K), R8.2
unnamed: D14.1 (K), R10.2
unnamed: D15.1 (K), R11.2
unnamed: D16.1 (K), R12.2
unnamed: D17.1 (K), R13.2
unnamed: Q12.1 (G), R30.2
unnamed: Q13.1 (G), R32.2
unnamed: Q14.1 (G), R34.2
unnamed: Q15.1 (G), R36.2
unnamed: Q16.1 (G), R38.2
unnamed: Q17.1 (G), R40.2
unnamed: Q18.1 (G), R42.2

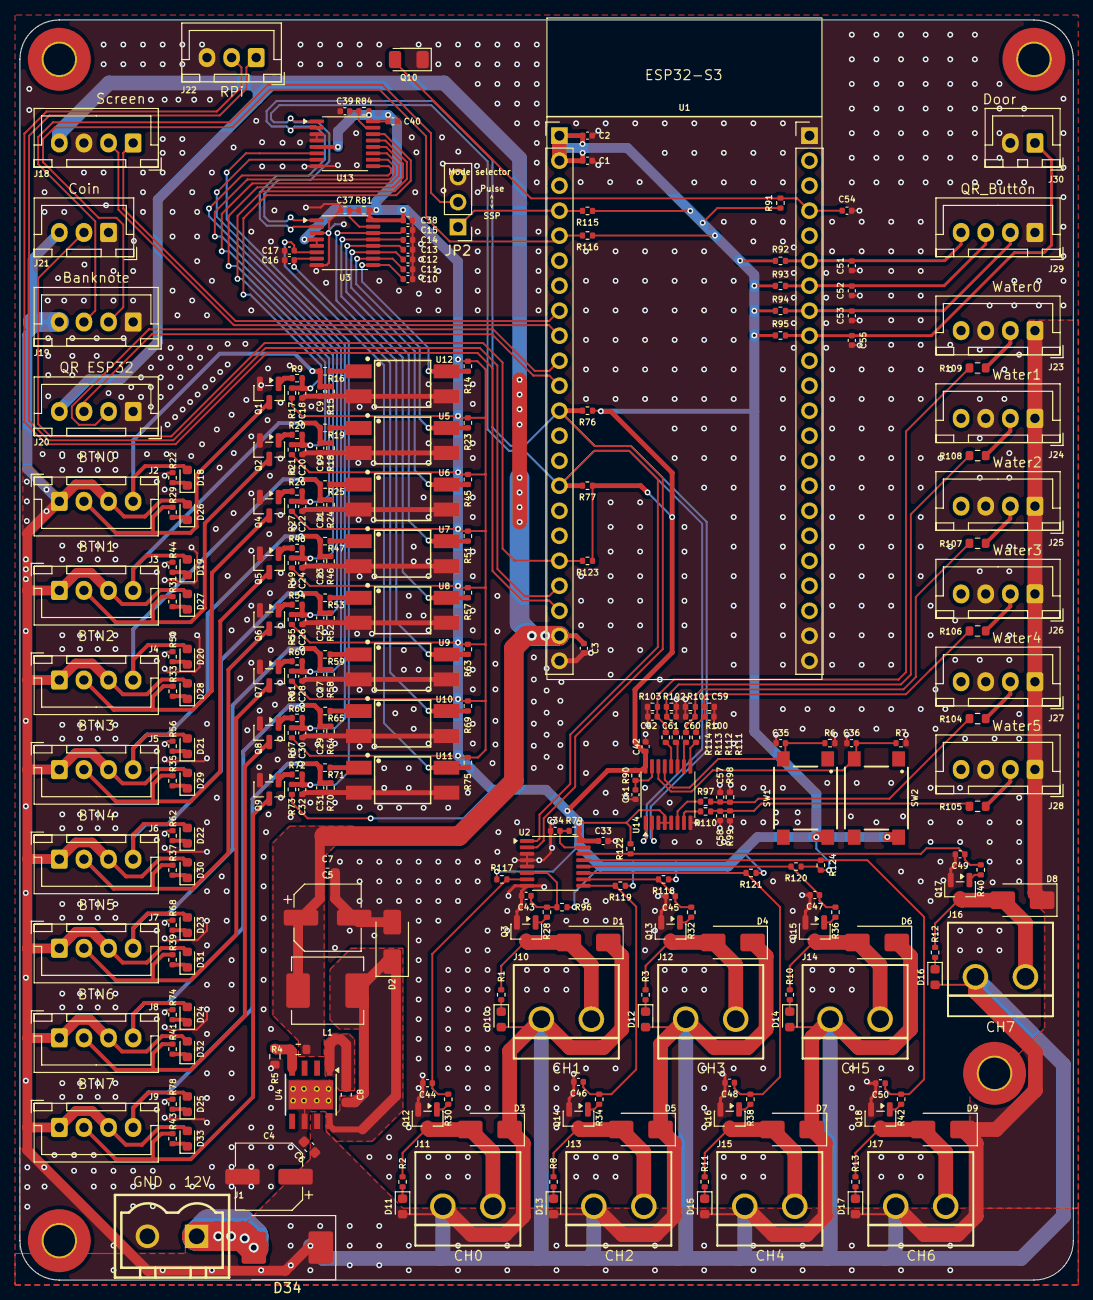
[picture p8: board PCB_CAT_Vending_Machine_V1.0.kicad_pcb from above]

Board: 2 copper layers, 107.0 x 128.0 mm, 280 parts (0 on the bottom side), 145 nets.
