Sopehurt/kiosk_pcb/(commit log)

2026-03-13 PCB Connector Position
    [PCB_CAT_Vending_Machine_V1.0.kicad_pcb]
2026-03-13 SCH finish
    [BTNkicad_sch.kicad_sch, Load.kicad_sch, Microcontroller.kicad_sch, PCB_CAT_Vending_Machine_V1.0.kicad_pcb, PCB_CAT_Vending_Machine_V1.0.kicad_sch, Peripheral.kicad_sch]
2026-03-15 finish no review
    [Microcontroller.kicad_sch, PCB_CAT_Vending_Machine_V1.0.kicad_pcb, PCB_CAT_Vending_Machine_V1.0.kicad_sch, Peripheral.kicad_sch, Power_supply.kicad_sch, bom.csv, designators.csv, positions.csv]
2026-05-17 to Kicad 10
    [BTNkicad_sch.kicad_sch, Connector.kicad_sch, Load.kicad_sch, Microcontroller.kicad_sch, PCB_CAT_Vending_Machine_V1.0.kicad_pcb, PCB_CAT_Vending_Machine_V1.0.kicad_sch, Peripheral.kicad_sch, Power_supply.kicad_sch]
